JacobHailemariam/james-gestures/cad/assembly.step

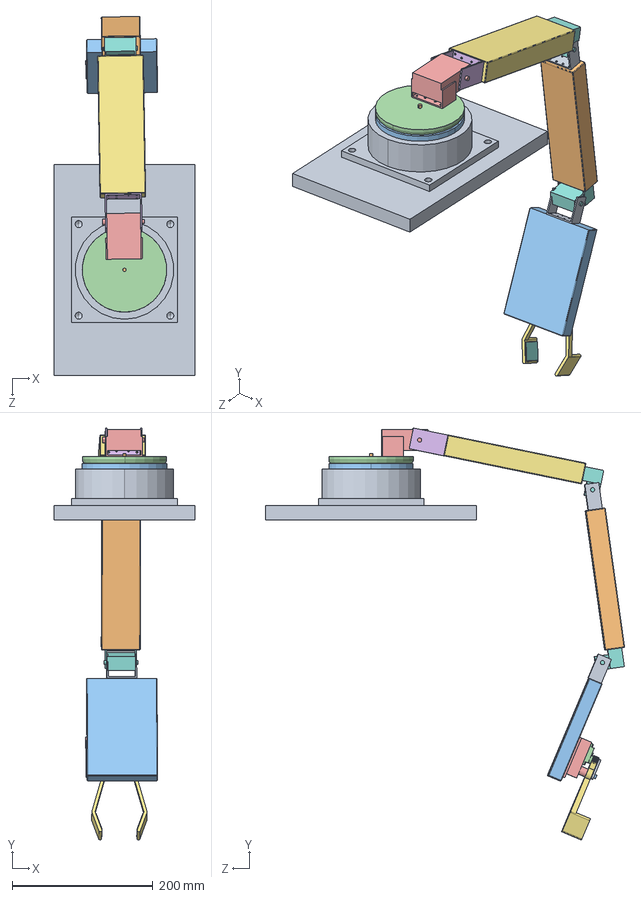
[picture p5: CAD file, 2026-10-25]
cad/assembly.step
200.0 x 585.0 x 509.9 mm
BaseNPlate
NEMARef
BaseLid
Link1
60ServoRef
Hinge60
Link2
25Servo x 2
Hinge25 x 2
Link3
Link4
servo_A.step
servo_B.step
housing.step
pinion_A.step
pinion_B.step
jaw_A.step
jaw_B.step
pad_A.step
pad_B.step
top_bridge.step
sleeve_A.step
sleeve_B.step
screw_M3x20_A.step
screw_M3x20_B.step
screw_M2_pinion_A.step
screw_M2_pinion_B.step
screw_M2_ear_A1.step
screw_M2_ear_A2.step
screw_M2_ear_B1.step
screw_M2_ear_B2.step
