JacobHailemariam/james-gestures/sim/meshes/link2.stl

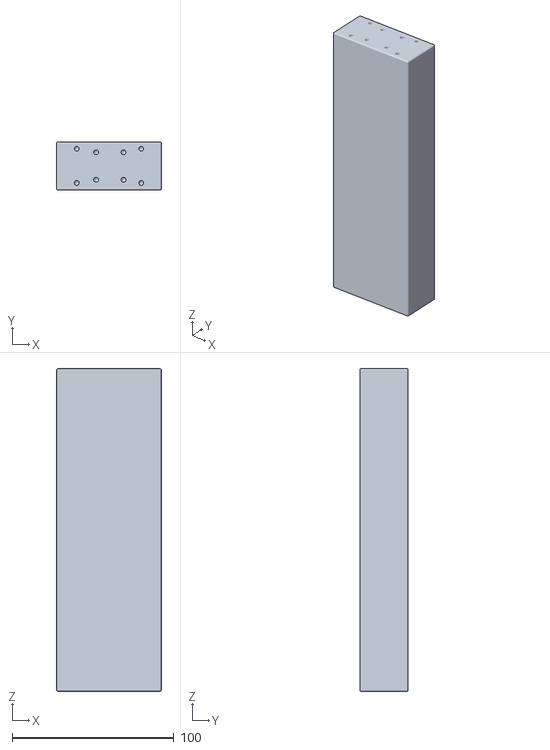
[picture p6: CAD file, 2026-10-24]
sim/meshes/link2.stl
65.0 x 30.0 x 200.0
