JacobHailemariam/james-gestures/cad/claw_print_plate.stl

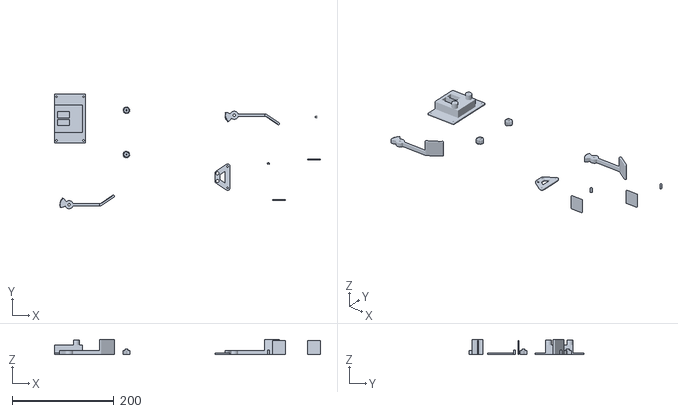
[picture p7: CAD file, 2026-10-25]
cad/claw_print_plate.stl
522.5 x 225.1 x 30.0
