JacobHailemariam/james-gestures/sim/meshes/link3.stl

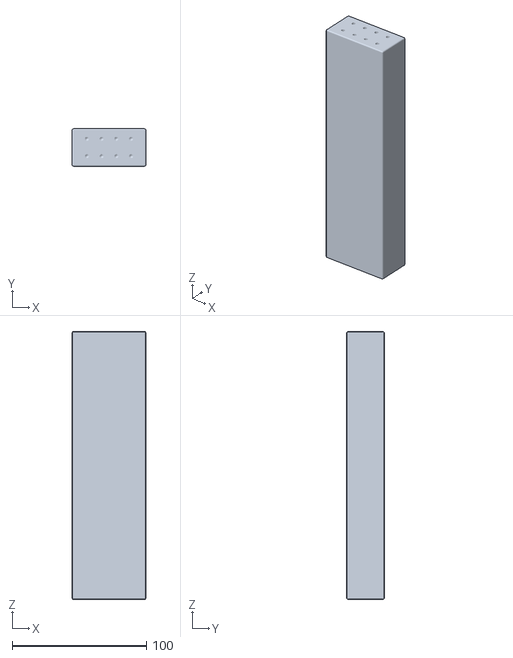
[picture p8: CAD file, 2026-10-24]
sim/meshes/link3.stl
55.0 x 28.0 x 200.0
