JacobHailemariam/james-gestures/sim/meshes/link1.stl

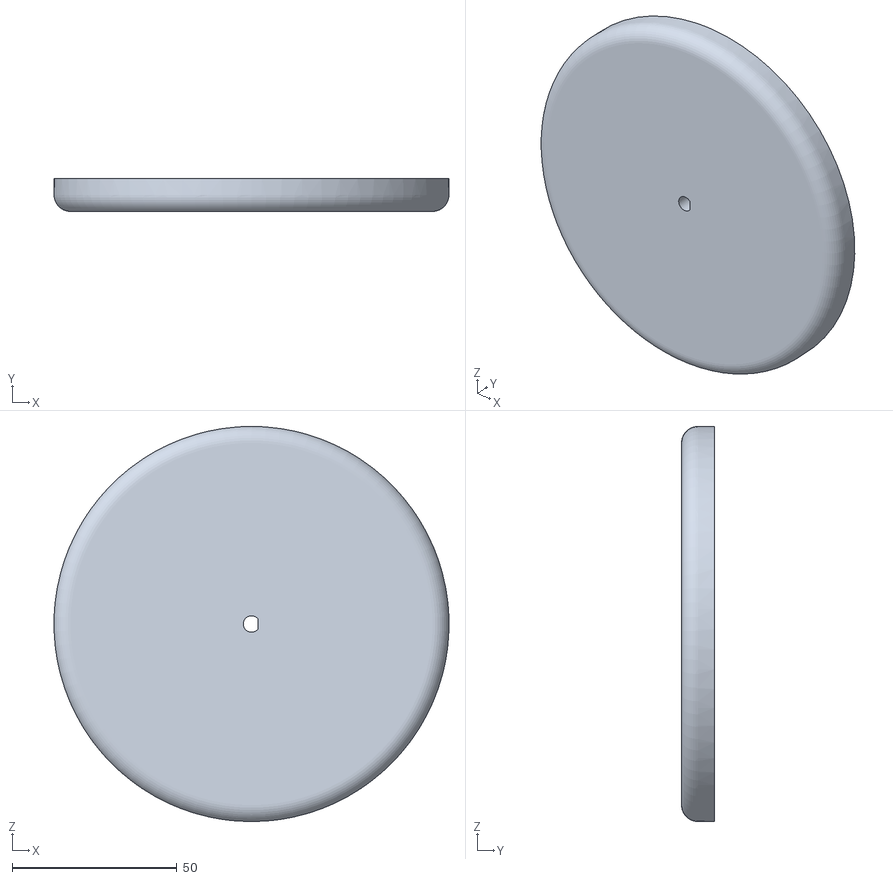
[picture p9: CAD file, 2026-10-24]
sim/meshes/link1.stl
120.0 x 10.0 x 120.0
