JacobHailemariam/james-gestures/sim/meshes/link4.stl

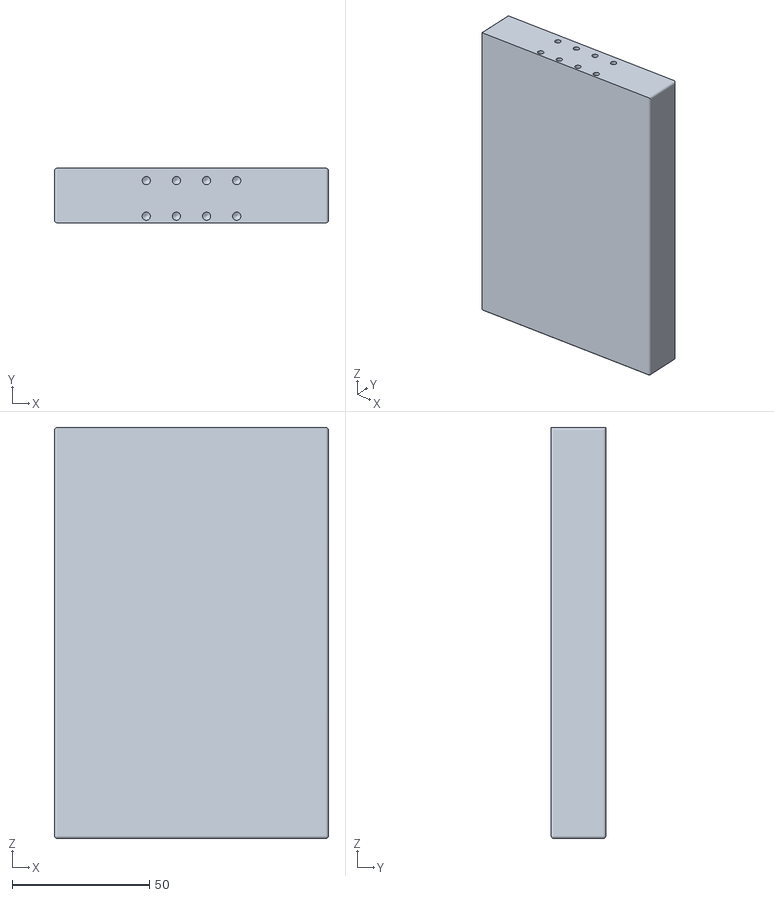
[picture p10: CAD file, 2026-10-24]
sim/meshes/link4.stl
100.0 x 20.0 x 150.0
