JacobHailemariam/james-gestures/sim/meshes/lid.stl

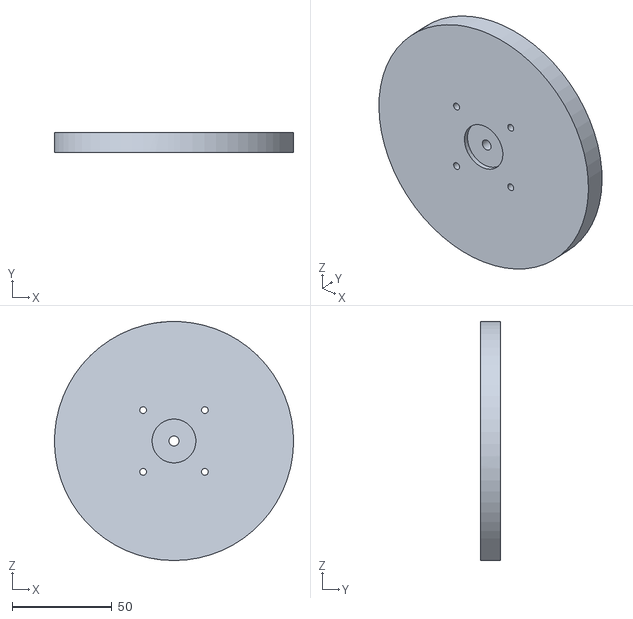
[picture p11: CAD file, 2026-10-24]
sim/meshes/lid.stl
120.0 x 10.0 x 120.0
