JacobHailemariam/james-gestures/sim/meshes/base.stl

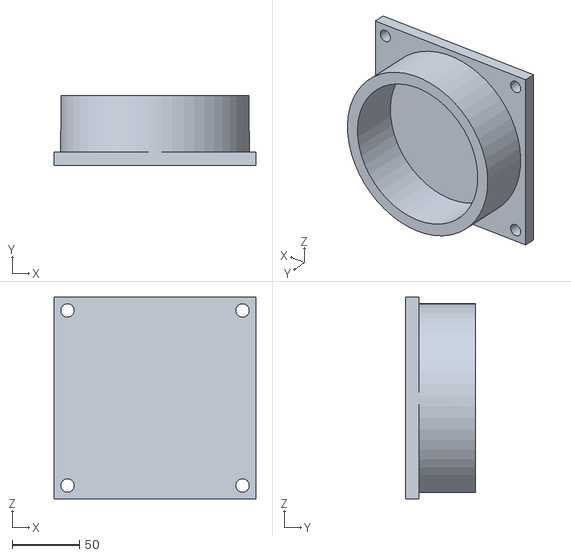
[picture p12: CAD file, 2026-10-24]
sim/meshes/base.stl
150.0 x 52.0 x 150.0
