JacobHailemariam/james-gestures/sim/meshes/RobotArm (1).3mf

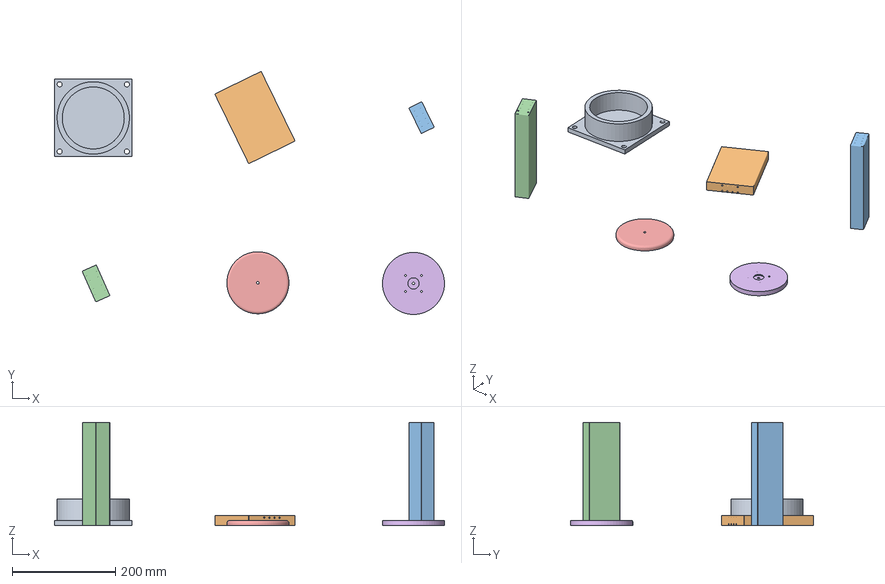
[picture p13: CAD file, 2026-10-24]
sim/meshes/RobotArm (1).3mf
754.5 x 470.0 x 200.0 mm
BaseNPlate.STL
Link4.STL
Link3.STL
Link2.STL
Link1.STL
BaseLid.STL
