JacobHailemariam/james-gestures/(commit log)

2026-10-24 Gesture + voice controlled robot arm: UNO Q firmware, MuJoCo sim, joystick steering
    - point/peace joystick drives one joint at a time; open palm idles, fist stops
    - MuJoCo model built from the printed STL parts (sim/meshes), --sim alongside --port
    - Arduino UNO Q sketch (Monitor-based serial), check_board.py connection test
    - offline Vosk voice commands
2026-10-24 UNO Q firmware: drive servos via PCA9685 and base via TB6600; add bringup sketch and motor test tool
    - arm_receiver_unoq.ino: replace direct Servo pins with a PCA9685 (I2C 0x40, 50 Hz,
    500..2500 us) on channels 0-3, and the A4988-style stepper with a TB6600 driver
    (PUL D9, DIR D3, ENA D4, 3200 pulses/rev). Servo outputs start off, ARM 1 enables,
    STOP/ARM 0 disarm. Reports when the PCA9685 is not found instead of hanging.
    - bringup_unoq.ino: one-at-a-time hardware check (I2C scan, servo sweep, 200-step
    base move, all off) typed from the Serial Monitor.
    - test_motors.py: type joint commands over the serial link for first power-up,
    clamped to the limits in james_gestures/arm.py.
    Co-A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
2026-10-25 Firmware: use the team-confirmed PCA9685 channels (shoulder 4, elbow 0, wrist 1, claw 15)
    The previous constants (0, 1, 2, 3) did not match the wiring, so a shoulder command
    would have pulsed the elbow servo. The bringup sweep now targets channel 4 as its
    comment says.
2026-10-25 Firmware: enable the TB6600 only while the base is moving, not on ARM 1
    Twice in a row the UNO Q rebooted the instant it received ARM 1. ARM 1 used to pull
    ENA low, which makes the driver push holding current through the stepper coils, and
    that load appears to brown out the board's supply. Now the driver is enabled right
    before the first base pulse and released again once the goal is reached, so arming
    and driving servos never load the stepper supply. STOP and ARM 0 still disable it.
    The real fix is giving the driver its own supply; this keeps bench testing possible.
    Not yet flashed: the board was unplugged when this was written.
2026-10-25 SerialLink survives the board dropping off USB; demo shows BOARD LOST and disarms
    Before, a board reboot mid-run killed demo.py with a SerialException traceback. Now
    send() never raises: the link marks itself lost, reopens COM3 about once a second,
    and PINGs until the sketch answers PONG before trusting it again. demo.py polls the
    link every frame, calls arm.stop() when it drops (a rebooted board is disarmed, so
    the controller must be too), and paints a red BOARD LOST line on the HUD.
    Three unit tests with a fake serial port cover: no exception on write failure,
    reconnect only after PONG, commands dropped while lost.
2026-10-25 tools/flash_unoq.py: push the sketch to the UNO Q over adb, restart the app, PING for PONG
    One command for the step we kept doing by hand tonight. Compile happens on the board.
    Nothing moves: the receiver starts disarmed.
2026-10-25 README rewritten to match the code; fix stale comments
    README: the joystick gesture mapping (point = base/shoulder, peace = wrist/elbow) replaces
    the old up/down table; all demo.py flags and keys; voice word table; joint limits table;
    UNO Q wiring from the firmware header; exact protocol; file table; troubleshooting from
    tonight's real failures; Windows commands first.
    Comments: bringup sketch said channel 0 while driving channel 4; test_motors.py described
    the old Servo-library snap; arm.py pointed at the old firmware path; tracker.py told users
    to download a model that ships in the repo.
2026-10-25 Gesture evaluation sweep and headless MuJoCo smoke tests
    tools/eval_gestures.py: synthetic hands (27 placements: 3 sizes x 3 positions x 3 rotations)
    through GestureReader + ArmController at jitter 0..25 % of palm size, white and correlated.
    Reports per-pose accuracy, confirm latency, flips per 1000 frames, ARM/STOP timing,
    pinch-in-fist rejection, joystick direction and rate limits.
    tests/test_sim_smoke.py: SimLink(show=False), arm via synth palm, every preset reaches
    its target within 1 deg, disarmed commands ignored, STOP freezes. 8 tests, skip without mujoco.
2026-10-25 Claw opens only on a real thumb release, not when a noisy frame un-confirms the pinch
    The synthetic sweep showed the pinch latch in handpose dropping a held pinch on a single
    noisy frame (10/27 holds at 8 % white jitter, 17/27 with slow drift), which sent CLAW 0 and
    would drop the object. The controller now ignores pinch -> False while the thumb-index gap
    is still at or below ArmConfig.claw_release_ratio (0.46 = pinch_ratio * pinch_release);
    it opens the claw once the gap is really above it. With this rule the sweep reported
    0/27 mid-pinch releases at every jitter level and release-opens-claw 27/27.
2026-10-25 Voice: require the wake word "james" before a command; measured 6.6 false commands/min -> 0
    With only the command grammar and min_conf 0.6, 100 s of hall noise with nobody talking to
    the laptop produced 11 false commands (release, raise, follow, stop) at confidence 0.8-1.0,
    so confidence alone could not filter them. A command now counts only within three words
    after a confident "james" in the same utterance; the same noise then produced 0 commands.
    "james" was chosen because noise produced it once in 100 s versus "arm" 6 and "robot" 3.
    Early stop from the partial result is kept but must show up in two consecutive partials.
    Pass wake=None to VoiceListener to go back to bare words.
    tools/eval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
2026-10-25 Base max speed 45 -> 90 deg/s; demo gets --speed multiplier and a deg/s readout on the joystick bar
    Pointing to the frame edge drove the base at its cap of 45 deg/s, which felt slow in the sim.
    The TB6600 at STEP_US = 1000 can do about 110 deg/s, so 90 leaves margin. --speed 2 doubles
    every joint's cap for experimenting without editing code; the HUD now prints the commanded
    deg/s next to the joint name so what you see is what is being sent.
2026-10-25 Joystick: lock the axis once a move starts, and end a move after 3 s until an open palm
    Jacob's request from the sim test: sliding left/right and then twitching the finger forward
    was read as "up" and moved the shoulder. Now, once the stick leaves the dead zone on one joint,
    that joint stays selected until you un-point (stick_lock_axis). And a move may last at most
    stick_max_s = 3 s from the moment it starts; then the stick goes dead, the HUD says "move window
    over: show an open palm, then point again", and an open palm re-enables it. STOP/disarm clear
    the gate too. Both are ArmConfig fields; stick_max_s = 0 turns the timer off.
    Four tests: a twitch can't switch joints, un-point frees the a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
2026-10-25 Sim: claw was drawn inverted (CLAW 1 spread the fingers). Now CLAW 1 brings them together
    The protocol, the controller and the firmware all treat CLAW 1 as closed; only the MuJoCo
    drawing had the slide offsets swapped, so 'james grab' looked like opening. Finger gap is
    now 4 cm on CLAW 0 and 0 on CLAW 1, checked straight from the model.
2026-10-25 Voice works with no hand in view: a command arms the arm by itself; hand-lost disarm waits for a hand
    "james home" from across the room used to print "ignored: arm it first" unless an open palm
    had been held, and a voice-armed arm with nobody in frame disarmed itself after 2 s. Now any
    claw or preset word arms a locked arm first (ArmConfig.voice_arms; "james follow" alone does
    not), and the hand-lost disarm only applies once a hand has actually driven since ARM 1.
    While a hand is in use nothing changes: lose it for 2 s and the arm disarms as before.
    Stop and fist are untouched.
2026-10-25 Four demo poses by voice (left/right shoulder, left/right hip) and "james save <pose>" into poses.json
    "james left shoulder" etc. go to a named pose like the other presets. The shipped angles are
    PLACEHOLDERS (raise/tuck with the base turned 45 deg either way): nobody has measured them on
    the real arm and which way is "left" depends on the mounting. To set them: steer to the pose
    in the sim and say "james save left shoulder"; the angles go to poses.json, which is loaded
    over PRESETS at startup. Saving works armed or not and records the arm's current position.
2026-10-25 Sim: the arm on the backpack (245x420x50, plate at (80,193) 150x150x10, 140 mm turntable); poses solved from geometry
    sim/arm.xml now has the bag standing on the floor with the mounting plate and turntable on its
    back face and the arm mounted with its base axis pointing out of the bag, in a frame whose origin
    is the bottom-left of the back face (x across, y out, z up). A "tip" site sits between the fingertips.
    tools/solve_poses.py searches base/shoulder/elbow/wrist within the joint limits for the pose
    that puts the fingertip on a target point without any link passing through the bag, using
    MuJoCo's forward kinematics only. The four demo poses in PRESETS are its output (0.0 mm error,
    no bag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
2026-10-25 Firmware: ANNIMOS servos sweep 270 deg over 500..2500 us, so convert real degrees per channel
    From the RDS5160SG (60 kg) and RDS3225SG (25 kg) datasheets: 500..2500 us = 270 deg, centre
    1500 us. The old 0..180 mapping would have driven "shoulder 160" (meant as +70 deg) to +105 deg,
    1.5x too far, and the joint limits in arm.py would have been meaningless. Now 90 = 1500 us and
    each degree is 7.41 us on the ANNIMOS channels, 11.1 us on the 9 g claw channel, so the sim's
    angles and the solved poses are what the real arm will do. Claw open/closed pulses unchanged.
    Also noted in the README. Not yet flashed: the board is still off USB.
2026-10-25 Add claw STL and arm assembly
2026-10-25 Add arm assembly step from solidwrks
2026-10-25 Sim arm dimensions from cad/assembly.step; poses re-solved
    Read Victor's STEP assembly with a small AP214 parser (part placements + bounding boxes):
    shoulder pivot 37 mm above the turntable and 65 mm off the base axis, shoulder->elbow 259 mm,
    elbow->wrist 247 mm, wrist->fingertips 249 mm (Link4 plus the gear claw). The model had 170 mm
    links and no base offset. The meshes are still the old prints and are only visual; capsules
    and boxes fill the gaps. Joint ranges unchanged (+-70, wrist +-90) until measured.
    With the longer arm the claw reaches ~160 mm in front of the back face, so the pose targets
    moved forward (shoulders y = -130 at z = 560; hips y = -120 at z = 150). Three poses hit to
    0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
2026-10-25 Sim viewer: drop MuJoCo's side panels, open maximized, overlay joint angles
    Top left shows base/shoulder/elbow/wrist in firmware degrees and the claw state; top right shows
    ARMED/DISARMED and the joint being steered. Tab / Shift+Tab still toggle the panels if needed.
2026-10-25 Servo slew limit in the firmware (60 deg/s); test_motors.py ramps moves
    First powered test: "shoulder 100" from test_motors.py went at the servo's full speed because
    the tool sent the target in one command. Two fixes. The firmware now keeps a goal per channel
    and moves the pulse toward it at SERVO_DEG_PER_S in 20 ms ticks, so no command from any source
    can snap an arm joint; a channel's first command still goes straight there (the servo's real
    position is unknown), and the claw is exempt. STOP/ARM 0 freeze the goals. test_motors.py
    sends every move as 30 Hz steps at the joint's max_speed times a 'speed' factor (default 0.5).
2026-10-25 Firmware: per-channel servo trim, and the first command on a channel snaps to home, then slews
    SERVO_TRIM_DEG[ch] is added to every command so protocol 90 can mean "limb straight" on the
    real arm regardless of how the horn was pressed on; calibrate with test_motors.py and fill in
    the numbers. A hobby servo can't report where it is, so the first pulse after power-up is
    always a jump: it now jumps to 90 (home) rather than to whatever was asked, and the move to
    the actual goal slews from there. Plug servo power in with the arm held near straight.
2026-10-25 "james home" is now the folded park pose; "james straight" is the all-1500-us pose
    Straight out is the worst case for the shoulder servo when the arm is worn (a 750 mm lever),
    so home no longer parks there. home = shoulder 30, elbow 150, base/wrist centred; straight
    = every joint 90 = 1500 us on every channel, the reference pose. Voice: "james home" / "park"
    / "reset", "james straight" / "extend". Key h still goes home.
2026-10-25 Firmware: two claw servos, channel 14 (left jaw, mirrored angle) and 15 (right jaw)
2026-10-25 Wrist locked straight on both sides; the four poses redone for a fixed wrist
    The claw sits loosely on the wrist, so a wrist swing can throw its gears. Firmware: WRIST_LOCK
    holds channel 1 at 90 (1500 us) and ignores every J wrist angle. Laptop: ArmConfig.lock_wrist
    (default on) keeps presets and the peace-joystick off the wrist; demo.py --wrist unlocks it.
    With the wrist fixed the fingertip can never be closer than ~630 mm to the shoulder, so the
    hip targets near the body are unreachable; the four poses are now the arm fully folded and
    pointed by the base: up-left/up-right for the shoulders, down-left/down-right for the hips.
2026-10-25 Send joint updates at most 10 Hz per joint (send_period_s), always ending on the exact target
    Jacob reported the arm executing old commands seconds late. The controller was sending a
    J line every frame for every moving joint, ~30/s per joint, ~90/s during a preset; the UNO Q
    pulls bytes from the laptop through an RPC to its Linux side, so a sustained burst backs up
    in that pipe and the sketch works through stale positions. Now a joint's position goes out
    at most every 0.1 s while it moves, and its final value is always sent; the firmware slew
    (60 deg/s) fills in between updates. send_period_s = 0 restores the old per-frame sends.
2026-10-25 Fix the review's demo blockers: preset lock, dropout grace, camera retry, PING handshake, resync
    From an adversarially verified review of the whole stack (11 confirmed findings):
    - A voice preset (even "james home" from power-on) locked hand steering until "james follow",
    so every gesture afterwards did nothing. Holding an open palm 1 s now takes steering back;
    the HUD says so.
    - One dropped MediaPipe frame restarted the 1 s arming hold; holds now survive a 0.3 s gap.
    - A failed cap.read() ended the demo silently; it now retries ~2 s and prints why it stopped.
    - SerialLink never checked the sketch was alive; it PINGs on open and reports BOARD LOST if no PONG.
    - After a board reboot the c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
2026-10-25 Revert the laptop side to 3b136f2 (home = all 90, the version that first worked); claw channels swapped
    Jacob asked to go back to the first version where "james home" and the sim runs worked.
    demo.py, james_gestures/, test_motors.py, tests/ and README are restored to 3b136f2. This
    drops later laptop changes: folded-home/straight, lock_wrist on the laptop side, the 10 Hz
    send limit, and the review fixes (palm takeback after a preset, dropout grace, camera retry,
    PING handshake, resync). They remain in history (845621d, 6207a83) to cherry-pick.
    Firmware stays current (two claw servos, slew, trim, WRIST_LOCK) with the claw channels
    swapped: left jaw 15, right jaw 14. The header comment block w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
2026-10-25 Issue 1: palm takeback waits until the preset arrives, so a resting open palm can't abort it
    Open palm is also the idle pose. With the re-applied takeback, someone holding a palm while saying
    'james raise' handed steering back on the next frame and the joystick froze the arm mid-move.
    Takeback now needs the preset to have arrived. Two tests cover it.
2026-10-25 Issue 5: voice no longer dies silently
    A bad audio chunk used to end the listener thread with nothing on screen. Now each chunk is
    guarded, a dead thread or a mic with no audio for 2 s sets VoiceListener.problem, poll() tries to
    reopen the mic every 3 s, and demo.py shows a red VOICE DOWN line and prints the change once.
    Four tests with a fake recognizer, mic and clock.
2026-10-25 Issue 2 (software side): background hands can't drive; real-hand tuning log
    - tracker.pick_driver: the largest hand drives only if its palm is at least --min-hand (0.05) of the
    frame height, so a passer-by can't take over when the operator's hand leaves. 0 turns it off.
    - demo.py --log hands.csv: one row per frame (label, detected, 4 finger ratios, gap, openness, size);
    keys 1-5 label the gesture being held. tools/tune_hands.py summarises recognition per gesture next to
    the thresholds. Thresholds themselves are unchanged until real numbers come in.
    - README flags, docs/ISSUES.md status table. 6 new tests.
2026-10-25 README: Atlas showcase for judges (hero, gesture GIF, build photos, how-it-works)
    Top of the README is now for judges: what Atlas is and who it is for, a GIF rendered from the real
    GestureReader and ArmController, the gesture table, build photos, parts list, a flow diagram, lessons
    and team. The original engineering notes are kept unchanged in a collapsible section below.
    Claude-Session: https://claude.ai/code/session_01WNPcLppZgm4mJcsvynTuod
2026-10-25 docs/NOTHING_MOVES.md: servos don't move on the arm; measured evidence and next steps for Victor
2026-10-25 Firmware: recover a reset PCA9685, wake servos one at a time; NOTHING_MOVES answer
    A PCA9685 whose supply dips resets itself: asleep, 200 Hz, outputs off, still answering on I2C. The
    receiver only set it up at boot, so after one dip every command was accepted and nothing moved. A
    watchdog now checks the prescale every 250 ms, re-sets the chip up and restores every pulse, and prints
    a WARN line. First pulses are queued one channel per 300 ms, so arming no longer starts five servos at
    stall current in the same millisecond. Protocol, pins and channels unchanged. Verified by compiling the
    sketch against mock libraries and replaying the team's command sequence, including a simulated reset.
    docs/N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
